SQiL918/MCU-/接线图/02_实物标注.png

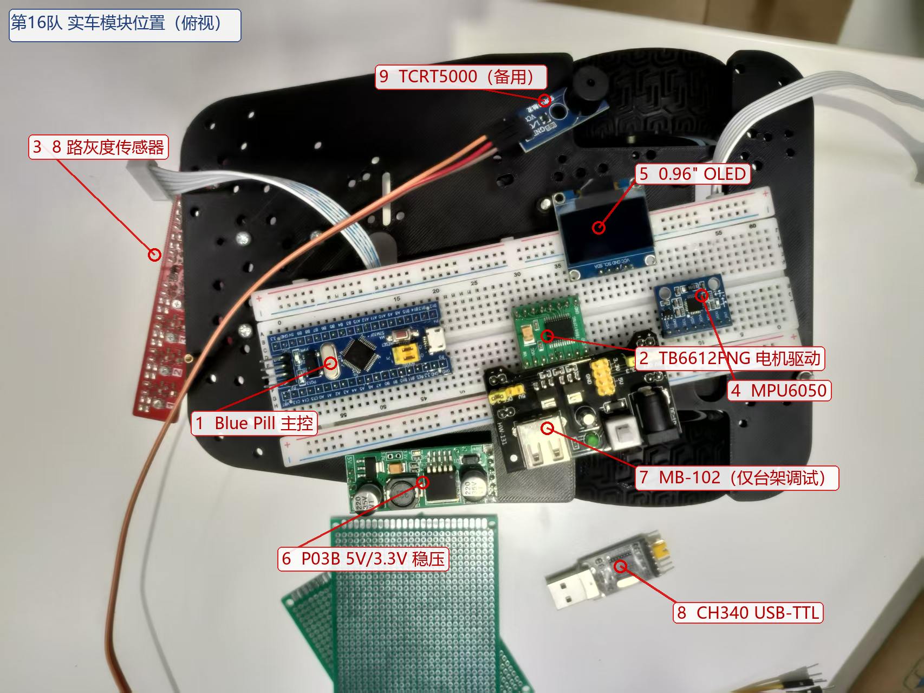
接线图/02_实物标注.png
