SQiL918/MCU-/README.md

# MCU- · 第16队 · 自动行驶小车

基于 Keil5 的小车循迹，原题 2024 年电赛 H 题改编，源码改编自德州电器部分源码与 Gitee 的菠萝虾。

- 题目：A 自动行驶小车
- 主控：STM32F103C8T6（Blue Pill）
- 开发环境：Keil MDK 5.36 + STM32F1 DFP 2.4.1，StdPeriph V3.5
- 当前版本：**release1.10**（2026-11-09，Q2 八路灰度串口循迹 r8）

## 先看这里

| 要做的事 | 打开 |
|---|---|
| 了解交付内容、待确认硬件、下一步 | [`交付说明.md`](交付说明.md) |
| 了解 release1.1 下载问题修复 | [`解决release1.0的问题.md`](解决release1.0的问题.md) |
| 提交设计报告 | [`设计报告/设计报告_自动行驶小车_可提交.docx`](设计报告/设计报告_自动行驶小车_可提交.docx)（8 页） |
| 接线 | [`接线图/接线总表.md`](接线图/接线总表.md)（先读第 1 节供电和第 11 节检查清单） |
| 编译/下载/标定 | [`Keil工程/README.md`](Keil工程/README.md) |
| 本版接线变更（灰度改串口） | [`Keil工程/README.md`](Keil工程/README.md) 第 3 节（OUT1~8 要拔掉） |
| 填登记表 | [`登记表_第16队_手写版.docx`](登记表_第16队_手写版.docx)（队伍信息已填，队员栏手写） |
| 记录调试数据 | [`调试记录/`](调试记录/)（测试记录表、参数标定表、四天计划） |
| 已编译固件 | [`Keil工程/Project.hex`](Keil工程/Project.hex) |

## 目录结构

```
MCU-/
├─ README.md                       仓库说明（本文件）
├─ 交付说明.md                      当前交付说明（先看这个）
├─ 解决release1.0的问题.md          release1.1 下载问题修复记录
├─ Project.hex                      当前版本固件（与 Keil工程/Project.hex 相同）
├─ 登记表_第16队_手写版.docx         队伍信息已填，队员栏手写（默认打印这份）
├─ 登记表_第16队_机打版.docx         姓名/班级/分工已机打，本人签字（备选）
├─ 设计报告/                        设计报告 docx/pdf（提交版，文件名不含队号）
├─ 接线图/                          接线总表 + 系统框图/实物标注/引脚图/流程图
├─ Keil工程/                        Keil5 工程（App/Bsp/Hardware/Library/Start/System/User）
├─ _仿真_主机验证/                   Q2 循迹主机仿真（MSVC 编译，非固件）
└─ 调试记录/                        四天计划、测试记录表、参数标定表
```

### 设计报告

- `设计报告_自动行驶小车_可提交.docx/.pdf`：唯一提交版，文件名不含队号。
- 表 3 的“实测”列留空，赛前联调按 4.1 节跑 3 次填入。

### 接线图

- `接线总表.md`：供电关系、逐引脚表、TB6612、MG513 6P、灰度 2×8、MPU/OLED、
  蜂鸣器/LED/按键/ADC、上电检查清单。
- 四张图：系统框图、实车标注、Blue Pill 引脚、软件流程。
- **release1.10 起灰度模块改接 UART（PA9/PA10），OUT1~8 排线全部拔掉**；
  `接线总表.md` 里的并口灰度接线是旧版，详见 [`Keil工程/README.md`](Keil工程/README.md) 第 3 节。

### Keil 工程

- 器件 STM32F103C8，StdPeriph V3.5，ARMCC V5。
- 200 Hz 控制、20 kHz PWM、TIM3/TIM4 编码器、软件 I2C、Q1~Q4 路径状态机。
- 首次上电必须标定：电机方向、编码器符号、轮径/计数当量、灰度极性、陀螺仪零偏。
- release1.1 修复：`Project.uvoptx` 中已关闭 Debug Description（`Enable=0`），
  解决“编译通过但无法烧录”（`Cannot access Memory @ 0x00000000`）；
  换电脑或换 ST-Link 后只需在 `Debug → Settings` 重选一次调试器，不要重新勾选该选项。

### 调试记录

- `四天计划与测试方案.md`：逐半日计划、里程碑、封存清单。
- `测试记录表.csv`、`参数标定表.csv`：与报告表 3 对应的记录模板，待实测填写。

## 当前状态

- 设计报告：8 页，摘要 262 字，格式符合模板；实测数据待回填。
- 登记表：队伍信息已填；队员姓名/班级/分工按备注由本人手写，另附机打备选版。
- Keil 工程：release1.10 编译 0 Error / 0 Warning（Flash 约 22.8 KB / RAM 约 3.2 KB，含 2 KB 栈）；2026-11-07 已实机下载成功（下载修复见 `解决release1.0的问题.md`）。
- 待确认硬件：MG513 6P 线序、TB6612 模块丝印、电池规格、轮径/轮距、
  蜂鸣器类型、灰度 10 芯排线顺序。

## release1.2 变更（2026-11-07，调参前备份）

跑图 PID 调参前的代码备份，相对 release1.1 的变化：

- 电池采样：改用 D153B 驱动板板载 1/11 分压，ADC 连续 8 次平均，
  新增 `VBAT_ADC_MULT`（=10）补偿分压比/参考电压误差
- 蜂鸣器：改为低电平触发（PB0 = 0 鸣响）
- 调试串口：新增 `gz`（陀螺仪 Z 轴角速度）、MPU6050 `WHO_AM_I`、陀螺仪零偏输出
- 电机/编码器方向：台架实测确认 `MOTOR_*_INVERT = 0` 前进，补充注释
- `Project.hex` 同步为本次构建固件

## release1.4 变更（2026-11-08，声光同步）

相对 release1.2（commit `5154800`），本次只改 `Keil工程/App/ui.c`：

- 新增 `ui_indicator()`：蜂鸣器 PB0、外接 LED PB2、板载 LED PC13 由同一函数驱动，
  启动/过点/停车时声音与灯光严格同步
- 删除 PC13 的 2 Hz 心跳，空闲时不再闪烁
- 提示节奏：启动 100 ms；过点 50/50/50 ms（响两下、闪两下）；停车 500 ms
- `Project.hex` 为本次构建（46,475 B，MD5 `D0CCB89DD44B5F72A2A894258111C6CA`），
  根目录与 `Keil工程/` 各一份、内容相同
- 烧录步骤与上电自检见当时的 `烧录说明.txt`（该文件已随后续版本移除，烧录步骤统一见 [`Keil工程/README.md`](Keil工程/README.md)）

## release1.7 变更（2026-11-08，MPU6050 Yaw 修复 + 电压校准）

相对 release1.4：

- MPU6050 上电初始化加固：上电先等 100 ms，`WHO_AM_I` 应答后最多重试 5 次，
  写完配置回读 `PWR_MGMT_1` 确认退出 sleep，失败时串口打印 `FAIL`
- 修正软件 I2C 读时序：地址 ACK 检查、首字节 ACK、末字节 NACK
- 陀螺仪校准增加量程检测：读数完全不变（stuck bus / 芯片仍在睡眠）判为坏，
  `Imu_IsReady()` 置 0
- OLED 的 `Y:` 在 IMU 未就绪时显示 `Err`，正常时显示 Yaw 数值
- 电池校准 `VBAT_ADC_MULT` 由 10 改为 8（万用表 12.4 V 时 OLED 约 15.55 V）
- `Project.hex` 47,563 B，MD5 `84E272F6D0BA0FFA6311212AB6B206A4`

## release1.9 变更（2026-11-08，Q2 转向修复）

相对 release1.7，只改 `Keil工程/App/path.c` 一行：

- `g_path_q2` 第二段半圆（D→A）的 `arc_dir` 由 `+1`（左转）改为 `-1`（右转），
  与 B→C 段一致；Q2 顺时针整圈 A→B→C→D→A 的转向正确
- `Project.hex` 47,563 B，MD5 `1AF3BE2B38FBC1F25F7DDB2E3702D51B`
- 当时包内的烧录说明同时记录当前限制：灰度 g=255 未解决、Q2 弧线为开环前馈、
  Q3/Q4 段表未改，建议低速单独核对

## release1.10 变更（2026-11-09，Q2 八路灰度串口循迹 r8）

本版把 Q2 的循迹方式整体换掉：灰度模块从 8 根并口线改成 **UART 115200**，
Q2 的直线和两个 180° 弧全部由八路灰度闭环跟线，IMU 只做航向内环和里程/角度保护。

- 新增 `Bsp/gray_uart.c/h`：串口帧解析（`5B` 帧头 + 8×12 位）、300 ms 掉线判定、
  自动重发上传命令 `A5 03 15 02`
- `App/path.c` 重写：新增 `SEG_LINE` / `SEG_ARC_LINE`；灰度误差积分成航向偏置
  （`ARC_LINE_*`，限幅 ±55°），弧线用几何前馈 + 灰度修正
- 弧线→直行增加 180° 交接：里程到后先停稳，航向差 >1° 就原地转到 180° 再直行
  （`ARC_SETTLE_*`）
- 新增 2 s 看门狗、限时等待与 `RST flags` / `FAULT` 诊断；USART1 中断优先级高于 TIM1；
  栈改为 2 KB
- **接线变化**：灰度 TX→PA10、RX→PA9，OUT1~8 全部拔掉；CH340 的 TX 不要再接 PA10
- 主机仿真 `_仿真_主机验证/`：把真实 `path.c` 编到 PC 上跑 Q2 场景（需 MSVC）
- 固件 `Project.hex` 64,295 B，MD5 `E3A9DE6F3D315903728E98747A0BCB13`

### 已知问题（实测，本版尚未解决）

1. 180° 方向调整不是每次都能到位，偶尔调整方向错误。
2. 第二段直行距离不够，到不了下一个半圆，灰度看不到线，第二次循迹失败。
3. 灰度循迹左右画龙、抖动过大，行驶不平稳。

## 版本

| 版本 | 日期 | 说明 |
|---|---|---|
| release1.0 | 2026-11-05 | 首次交付：Keil 工程、设计报告、接线图、调试记录、登记表 |
| release1.1 | 2026-11-07 | 修复 Keil 下载问题：关闭 Debug Description（.dbgconf），实机烧录成功 |
| release1.2 | 2026-11-07 | 调参前备份：电池采样、蜂鸣器、调试串口更新，准备跑图调 PID |
| release1.4 | 2026-11-08 | 声光同步：`ui_indicator()` 统一驱动蜂鸣器/PB2/PC13，过点声光同步 |
| release1.7 | 2026-11-08 | MPU6050 上电初始化修复，OLED 可读 Yaw；`VBAT_ADC_MULT=8` |
| release1.9 | 2026-11-08 | Q2 第二段半圆（D→A）改为右转，顺时针整圈方向正确 |
| release1.10 | 2026-11-09 | Q2 改八路灰度串口循迹 + 180° 交接；已知抖动、第二段距离不足 |
