SQiL918/MCU-/解决release1.0的问题.md

# MCU 二面 · 第16队 · 工作目录

题目 A：自动行驶小车。主控 STM32F103C8T6。
比赛时间：2026-11-05 08:00 — 2026-11-08 20:00。

## 版本记录

**release1.1（2026-11-07）· 修复 Keil 下载问题：** 此前本工程出现“编译通过但无法烧录”——Keil 报 `Cannot access Memory (@ 0x00000000, Write, Acc Size: 8 Byte)`，命令行下报 `No ST-LINK detected`，而同一台电脑、同一只 ST-Link 烧录其他 LED 工程正常；根因是工程的用户配置文件 `Project.uvoptx` 中开启了 **Debug Description（.dbgconf 调试描述）**，Keil 会在连接芯片前按 `DebugConfig\*.dbgconf` 去写 DBGMCU 调试寄存器，这一步失败就把错误报在 0 地址并中止下载；解决方法是在 `Options for Target → Debug` 中关闭 Debug Description（或退出 Keil、删除 `Project.uvoptx` 后重开工程，在 `Debug → Settings` 里重新选中本机 ST-Link），本工程已改为 `DebugDescription/Enable = 0`，实测编译 0 Error / 0 Warning、下载成功；换电脑或换 ST-Link 后若再提示找不到调试器，只需在 `Debug → Settings` 里重选一次，不要重新勾选该选项。

## 先看这里

| 要做的事 | 打开 |
|---|---|
| 了解交付内容、待确认硬件、下一步 | `交付说明.md` |
| 提交设计报告 | `设计报告/设计报告_自动行驶小车_可提交.docx`（8 页） |
| 接线 | `接线图/接线总表.md`（先读第 1 节供电和第 11 节检查清单） |
| 编译/下载/标定 | `Keil工程/README.md` |
| 看原始题目和材料 | `原始材料/` |
| 填登记表 | `提交包/登记表_第16队_手写版.docx`（队伍信息已填，队员栏手写） |
| 记录调试数据 | `提交包/调试记录/`（测试记录表、参数标定表、四天计划） |
| 发给李队的整包 | `提交包/第16队_交付包_2026-11-05.zip` |

## 目录说明

```
MCU二面/
├─ 交付说明.md              当前交付说明（先看这个）
├─ 设计报告/               设计报告 docx/pdf（提交版，文件名不含队号）
├─ 接线图/                 接线总表 + 系统框图/实物标注/引脚图/流程图
├─ Keil工程/               Keil5 工程（App/Bsp/Hardware/System/User）
├─ 过程文档/               题目分析、方案、计划、测试表、答辩要点
├─ 原始材料/               题目原件、参考资料、李队发来的材料
├─ 提交包/                 交付 zip、登记表、调试记录表
└─ 归档/                   报告/接线图的生成脚本（重建用）
```

### 设计报告

- `设计报告_自动行驶小车_可提交.docx/.pdf`：唯一提交版，文件名不含队号。
- 表 3 的“实测”列留空，赛前联调按 4.1 节跑 3 次填入。

### 接线图

- `接线总表.md`：供电关系、逐引脚表、TB6612、MG513 6P、灰度 2×8、MPU/OLED、
  蜂鸣器/LED/按键/ADC、上电检查清单。
- 四张图：系统框图、实车标注、Blue Pill 引脚、软件流程。

### Keil 工程

- 器件 STM32F103C8，StdPeriph V3.5，ARMCC V5。
- 200 Hz 控制、20 kHz PWM、TIM3/TIM4 编码器、软件 I2C、Q1~Q4 路径状态机。
- 首次上电必须标定：电机方向、编码器符号、轮径/计数当量、灰度极性、陀螺仪零偏。

### 过程文档

按阅读顺序：题目规则 → 团队分工 → 技术方案 → 四天计划 → 待确认信息 →
报告大纲 → 上游代码分析 → 安全叮嘱 → 答辩要点 → 测试记录表 → 参数标定表 →
开源项目对比。

## 当前状态

- 设计报告：8 页，摘要 262 字，格式符合模板；实测数据待回填。
- 登记表：队伍信息已填；队员姓名/班级/分工按备注由本人手写，另附机打备选版。
- Keil 工程：Keil MDK 5.36 + DFP 2.4.1 编译通过（0 Error / 0 Warning，Flash 16.4 KB / RAM 1.8 KB）；2026-11-07 已实机下载成功（下载问题与修复见上方“版本记录”）。
- 待确认硬件：MG513 6P 线序、TB6612 模块丝印、电池规格、轮径/轮距、
  蜂鸣器类型、灰度 10 芯排线顺序。
