SQiL918/MCU-/交付说明.md

# 交付说明（2026-11-05 晚）

## 1. 这次交付了什么

| 文件/目录 | 内容 | 状态 |
|---|---|---|
| `设计报告/设计报告_自动行驶小车_可提交.docx` | 按学校模板生成的设计报告，8 页，262 字摘要 | 可提交，实测数据待回填 |
| `设计报告/设计报告_自动行驶小车_可提交.pdf` | 同上 PDF，便于预览/打印 | 8 页 |
| `接线图/接线总表.md` | 逐引脚接线表、供电关系、6P 编码器识别、上电检查清单 | 完成 |
| `接线图/01_系统框图.png` | 系统总体框图（报告图1） | 完成 |
| `接线图/02_实物标注.png` | 实车模块位置标注（报告图2） | 完成 |
| `接线图/03_BluePill引脚图.png` | Blue Pill 引脚分配图（备用/讲解用） | 完成 |
| `接线图/04_软件流程图.png` | 软件总体流程（报告图3） | 完成 |
| `Keil工程/` | Keil5 工程，可直接编译/下载 | Keil MDK 5.36 + DFP 2.4.1 编译通过，0 Error 0 Warning |
| `Keil工程/README.md` | 编译、下载、标定、串口、故障排查 | 完成 |
| `提交包/登记表_第16队_手写版.docx` | 队伍信息已填，队员姓名/班级/分工留空，供本人手写 | 默认打印这份 |
| `提交包/登记表_第16队_机打版.docx` | 姓名/班级/分工已机打，本人只需签字 | 备选 |
| `调试记录/四天计划与测试方案.md` | 逐半日计划、里程碑、封存清单 | 完成 |
| `调试记录/测试记录表.csv` | 每次跑车记录模板，列与报告表 3 对应 | 待填 |
| `调试记录/参数标定表.csv` | 轮径、轮距、编码器、死区、IMU、灰度、PID 标定 | 待填 |
| `原始材料/材料_2026-11-05/` | 李队发来的材料解压（手册、例程、三维模型） | 参考 |

## 2. 报告怎么用

- 封面：题目编号 A、题目名称“自动行驶小车”，参赛队编号/校区留空；
  如学校要求填，按现场要求填。正文没有出现学校、姓名、队号。
- 摘要：262 字，符合 300 字以内。
- 格式：A4，上边距 3.0 cm，小四宋体，固定 22 pt 行距，页码右下角。
- PDF 已用 WPS 导出复核：8 页，正文、图表、页码正常。
- 4.2 节表 3 的“实测”列是空的，赛前联调后按 4.1 节重复 3 次填入；
  这是唯一需要你们补的数据。
- 为压到 8 页，报告正文没有放附录 A/B 和参考文献；如果评委允许超页，
  可以把 `Keil工程/README.md` 的引脚表、`app_config.h` 的参数表、
  代码节选补到附录。当前 8 页是硬限制下的版本。

## 3. 接线图怎么用

1. 先看 `接线图/接线总表.md` 第 1 节供电关系：电池→保险丝→开关→P03B/TB6612，
   所有 GND 星形汇接。
2. 按第 2 节引脚表逐根接；灰度 OUT 全部接在 5 V 容忍引脚上。
3. 按第 4 节用万用表确认 MG513 的 6P 线序（M1/M2、VCC、GND、C1、C2），
   **不要凭颜色直接插**。
4. 按第 5 节接灰度 2×8 排针：OUT1~8 + 5V + GND，TX/RX/SCL/SDA/SWD 留空。
5. 按第 11 节上电检查清单，先架空车轮、限流 0.5 A，再落地。

## 4. Keil 工程怎么用

1. 打开 `Keil工程/Project.uvprojx`，器件选 STM32F103C8，编译。
2. ST-Link 接 SWDIO/SWCLK/GND/3.3V；BOOT0=0，按复位下载。
3. 首次上电按 `Keil工程/README.md` 第 4 节标定：
   电机方向、编码器符号、轮径/计数当量、灰度极性、陀螺仪零偏。
4. 先低速 300~450 mm/s 跑 Q1/Q2，再提速；Q3/Q4 的 38.66°转向参数
   `TURN_KP` 先保持默认 5.0。
5. 工程已在本机 Keil MDK 5.36 实测编译：0 Error / 0 Warning，Flash 16.4 KB；
   `Keil工程/Project.hex` 是现成固件，可直接烧录。

## 5. 还需要李队确认/补的硬件事实

这些不影响代码框架，但会影响第一次上电是否顺利：

1. **电池**：几 S、容量、有没有 12 V 电池盒/XT60/DC 头、有没有 5 A 保险丝和开关。
   代码按 3S（11.1 V，满电 12.6 V）设计；如果是 2S，速度会低一些，仍能跑。
2. **MG513 6P 线序**：按接线总表第 4 节用万用表确认；确认后把线色/顺序拍照发我。
3. **TB6612 模块丝印**：绿色模块不同批次引脚顺序可能不同；以丝印为准，
   确认 VM/VCC/GND、PWMA/AIN1/AIN2/STBY/BIN1/BIN2/PWMB 的位置。
4. **轮径/轮距**：用卡尺量轮子直径、两轮中心距；如果轮径不是 65 mm，
   改 `COUNTS_PER_MM` 和 `WHEEL_DIAMETER_MM`。
5. **蜂鸣器**：确认是有源还是无源；无源需要改代码输出 2 kHz PWM。
6. **灰度排线**：现有 10 芯排线如果已经压好，用万用表逐根确认
   OUT1~8 + 5V + GND 的顺序，不要假设。
7. **Q3 原地转向规则**：当前代码用“内轮停、外轮进”的前进式转向，
   不反转；如果裁判认为内轮停也不符合“只能前进”，改为
   `TURN_INNER_RATIO=0.3`（两轮都前进，转半径更大）。

## 6. 建议的下一步（按优先级）

1. **今天/明天上午**：按接线总表接好电源、主控、TB6612、编码器、灰度、MPU、OLED；
   架空车轮，烧录，串口确认 `BOOT`、`IMU calibration done`。
2. **明天下午**：标定电机方向、编码器符号、轮径、灰度极性；跑 Q1 直线，
   调 `YAW_KP`；再跑 Q2 圆弧，调 `LINE_KP/KD`。
3. **11 月 7 日**：跑 Q3 的 38.66°转向和对角线；调 `TURN_KP`、
   `ARC_FINISH_MARGIN_MM`；补表 3 实测数据。
4. **11 月 8 日**：Q4 四圈连续测试；检查电池电压、轮胎、保险丝；
   按 `过程文档/04_四天计划与测试方案.md` 的封存清单打包。

## 7. 登记表怎么填

登记表由参赛队自己填，评委只填“实车/报告得分、总分、评委签字”。原件备注写明：
“队员信息与分工由队员本人填写并签字”。所以给了两版：

- `登记表_第16队_手写版.docx`：只印好队伍名称/编号/题目，队员三行空着，本人手写。**默认打这份。**
- `登记表_第16队_机打版.docx`：姓名/班级/分工已打好，本人核对后签字。赶时间用这份。

| 栏位 | 填法 |
|---|---|
| 队伍名称 | 第16队（已印） |
| 队伍编号 | 16（已印，如群里有三位编号现场改） |
| 参赛题目 | 自动行驶小车（原件已印） |
| 队员姓名/班级（1→3） | 李队 25区块链2班；梁亮 24计算机1班；蔡宇 26电气G1班 |
| 分工（1→3） | 李队 硬件方案/电源与结构/整车统稿；梁亮 软件设计/控制算法/程序调试；蔡宇 接线与硬件调试/测试记录/报告排版 |
| 测试日期 | 测试当天填 |
| 本人签字、队长签字 | 本人签，不代签 |
| 评分、总分、评委签字 | 全部留空，评委填 |

登记表**不是匿名材料**，姓名、班级必须真实；匿名要求只针对设计报告。

## 8. 风险提醒

- **电源**：P03B 输入标 12/24 V，3S 满电 12.6 V 没问题；不要同时接 MB-102 的 5 V
  和 P03B 的 5 V。
- **灰度 OUT 高电平约 4 V**：已接 FT 引脚；不要改到 PA0~PA7/PB0/PB1 等非 FT 脚。
- **编码器 VCC**：默认 3.3 V，保护 PA6/PA7；如果该批次必须 5 V，必须加限幅。
- **TB6612 电流**：连续 1.2 A/通道，不要让轮子长时间堵转；VM 端并 100 µF。
- **报告页数**：当前 8 页；如果补附录会超页，优先保留正文和表 3。
