SQiL918/MCU-/接线图/03_BluePill引脚图.png

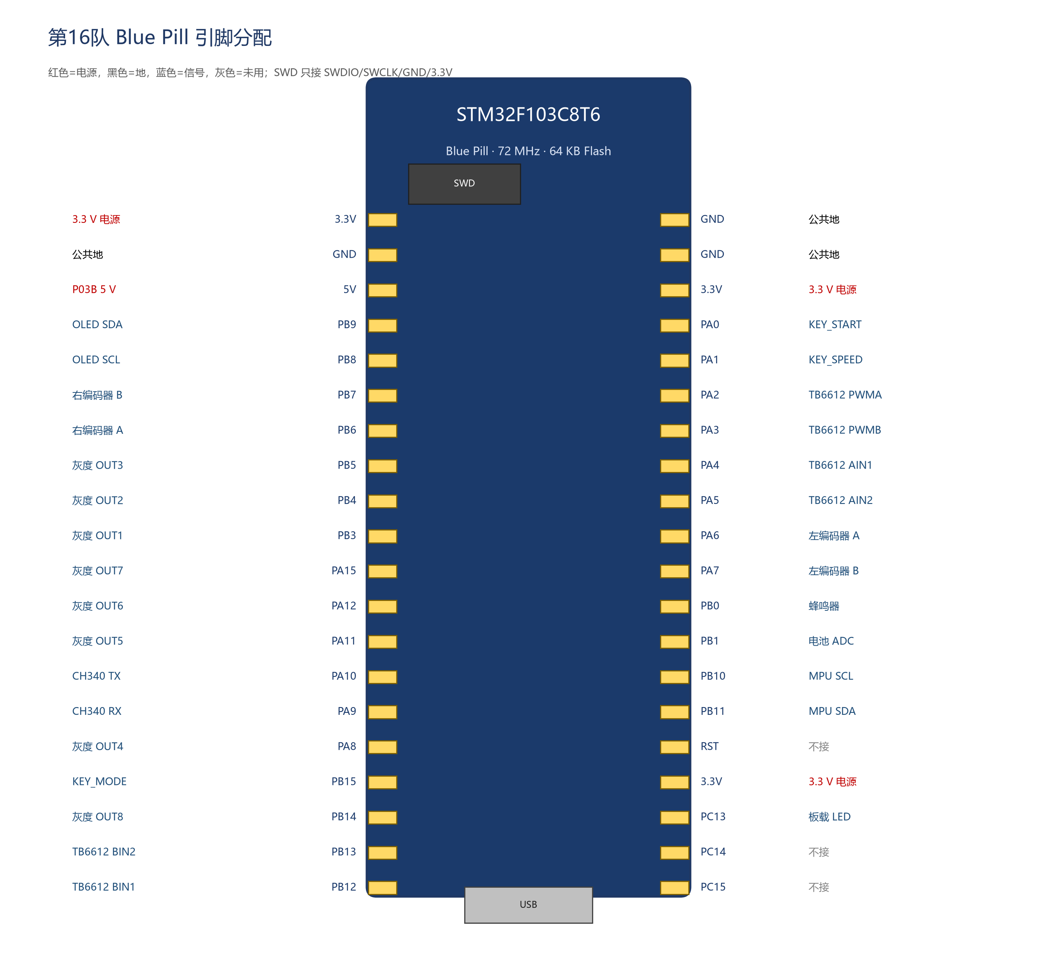
接线图/03_BluePill引脚图.png
