SQiL918/MCU-/调试记录/四天计划与测试方案.md

# 四天作战计划与测试方案

时间基准：2026-11-05 13:20 — 11-08 20:00，约 78.5 小时。
原则：**先通模块，再通单题，再通全程；先保稳定，再提速；报告同步写。**

## 1. 逐半日计划

### 11-05（D0）今天

| 时间 | 任务 | 产出/验收 |
|---|---|---|
| 13:30–15:00 | 硬件盘点、拍照、要手册；确认主控/驱动/灰度/IMU/OLED/电池 | 硬件清单填完；引脚丝印照片 |
| 15:00–16:00 | 电源检查：极性、短路、5 V/3.3 V、共地；只给主控上电 | 主控 3.3 V 正常，SWD 能连 |
| 16:00–17:00 | 开发环境：新建工程、时钟 72 MHz、LED 闪、下载成功 | 能编译/下载/复位 |
| 17:00–18:00 | OLED、按键、蜂鸣器、LED 自检 | 显示/翻页/响/亮 |
| 18:00–20:00 | 电机方向、PWM、编码器计数；架空测 | 两轮正转，计数正确 |
| 20:00–22:00 | 灰度读数、IMU 读数、ADC 电压 | 串口/OLED 能看到数据 |
| 22:00–23:30 | Q1：A→B 直行停车 | 连续 3 次成功，记时间 |

**D0 必须达到**：所有模块能读/能动；Q1 能跑。达不到就压缩后面的功能，不要跳过电源检查。

### 11-06（D1）

| 时间 | 任务 | 产出/验收 |
|---|---|---|
| 08:30–10:00 | 速度环整定（左右独立） | 阶跃无明显振荡 |
| 10:00–12:00 | 航向环整定；直道 100 cm 偏差 | 偏差 ≤ 3 cm |
| 13:30–15:30 | 灰度阈值/高度；圆弧低速循迹 | 圆弧不脱线 |
| 15:30–18:00 | Q2 全路径：直道→弧→直道→弧→停车 | 单圈 ≤ 30 s，连续 3 次 |
| 18:00–19:00 | OLED 队名/轮速/调速界面 | 5 分项可演示 |
| 19:00–22:00 | Q2 提速与稳定性；记录数据 | 10 次通过率 ≥ 70% |
| 22:00–23:00 | 代码 commit、备份；报告方案/理论初稿 | 有可回滚版本 |

**D1 必须达到**：Q2 连续 3 次 ≤ 30 s；OLED 5 分项能演示。

### 11-07（D2）

| 时间 | 任务 | 产出/验收 |
|---|---|---|
| 08:30–10:00 | Q3 斜线：航向 + 距离闭环 | 斜线偏差 ≤ 3 cm |
| 10:00–12:00 | C/B/D 点位对准、找弧、换向 | 单圈 ≤ 40 s |
| 13:30–16:00 | Q3 全路径连续跑 | 连续 3 次成功 |
| 16:00–18:00 | Q4 四圈：圈数状态机、A 点重新对准 | 至少 1 次完整四圈 |
| 18:00–20:00 | Q4 稳定性/提速；记录 | 不脱线优先 |
| 20:00–22:00 | 回归 Q1/Q2，防止改坏 | 各 3 次通过 |
| 22:00–23:00 | 报告测试数据整理；代码备份 | 数据表填完 |

**D2 必须达到**：Q3 单圈 ≤ 40 s；Q4 至少 1 次完整。达不到就保 Q2，Q3/Q4 尽力。

### 11-08（D3）

| 时间 | 任务 | 产出/验收 |
|---|---|---|
| 08:30–10:30 | 最后调参；连续 10 次稳定性 | 通过率 ≥ 80% |
| 10:30–12:00 | 选定比赛版本；烧录；记录参数 | 已知-good hex + 参数表 |
| 12:00–13:00 | **代码冻结**；两份备份；整理工具/备件 | 不再改功能 |
| 13:00–15:30 | 报告统稿：摘要、图表、测试数据 | 8 页内，格式合规 |
| 15:30–17:00 | 打印、装订、密封纸、页码检查 | 符合提交要求 |
| 17:00–18:30 | 实物检查：螺丝、线、电池、轮胎、备用件 | 封箱清单 |
| 18:30–19:30 | 封箱前最后通电自检（按评委要求） | 程序脱机固化 |
| 20:00 | 停止调试，封存 | 报告/实物/登记表 |

## 2. 里程碑与 Go/No-Go

| 里程碑 | 时间 | 通过标准 | 不通过怎么办 |
|---|---|---|---|
| M1 模块全通 | 11-05 23:00 | 每个模块能读/能动 | 第二天上午补，砍非必要功能 |
| M2 Q1 | 11-05 23:30 | 3/3 成功 | 先修电源/编码器，不急着 Q2 |
| M3 Q2 | 11-06 23:00 | 3/3 ≤ 30 s | 降速，保不脱线 |
| M4 Q3 | 11-07 12:00 | 1/1 ≤ 40 s | 先保 Q2，Q3 用低速 |
| M5 Q4 | 11-07 23:00 | 至少 1 次完整 | 11-08 上午继续，仍不成就保 Q3 |
| M6 稳定性 | 11-08 10:30 | 10 次 ≥ 8 次 | 冻结当前最好版本 |

## 3. 测试矩阵

| 测试 | 次数 | 通过标准 | 记录项 |
|---|---|---|---|
| Q1 A→B | 10 | 停车覆盖 B，声光同时，≤ 15 s | 时间、停车偏差、提示 |
| Q2 单圈 | 10 | 每点提示，弧线不脱，≤ 30 s | 时间、脱线次数、漏提示 |
| Q3 单圈 | 10 | 每点提示，弧线不脱，≤ 40 s | 时间、脱线次数、斜线偏差 |
| Q4 四圈 | 5 | 4 圈完整，停车覆盖 A | 总时间、脱线、圈数 |
| OLED/调速 | 3 | 队名、左右轮速、调速可见 | 照片/视频 |
| 低电压 | 1 | 电压下降后仍能跑/报警 | 电压、现象 |
| 连续稳定性 | 10 | ≥ 8 次通过 | 通过率、失败原因 |

测试条件固定：同一地面、同一光照、同一胎压/轮胎清洁、同一电池起始电压、同一场地位置。每次测试前把车放回 A 点同一位置/方向。

## 4. 每次跑车前后检查清单

跑前：

- [ ] 电池电压 ≥ 约定值（满电或 ≥ 7.4 V，按实际电池）
- [ ] 轮子/电机线/传感器线无松动
- [ ] 灰度镜头干净，高度未变
- [ ] IMU 固定牢，yaw 已归零/无漂移
- [ ] 场地 A/B/C/D 位置未动
- [ ] OLED 显示模式/速度正确

跑后：

- [ ] 记录时间、脱线、漏提示、停车位置
- [ ] 摸电机/驱动是否过热
- [ ] 检查电池电压
- [ ] 保存异常现象（视频/照片）
- [ ] 如果改了参数，记下旧值/新值

## 5. 代码冻结与备份

1. **11-08 13:00 冻结**：不再加功能，不再改控制参数；只允许修“导致不能跑”的问题，且要回归 Q1/Q2。
2. 备份两份：笔记本 + U 盘；包含源码、hex、参数表、接线图、报告。
3. 烧录后**脱机运行**验证一次（拔掉 ST-Link，重启，跑 Q1）。
4. 记录“比赛版本”的 commit/tag、编译时间、参数表；封箱后不再改。
5. 工具清单：ST-Link、USB 线、备用电池、螺丝刀、扎带、绝缘胶带、万用表、备用传感器/电机、充电器。

## 6. 封存清单

- [ ] 《设计报告》打印/装订/密封纸/页码/无学校姓名队号
- [ ] 制作实物（车、电池、遥控？不允许遥控；只封车和必要附件）
- [ ] 《登记表》
- [ ] 程序已脱机固化
- [ ] 未封入箱的开发板、仿真器、U 盘不带入测评现场
- [ ] 封条/签字/拍照留证

## 7. 时间不够时的取舍

优先级从高到低：

1. Q1 + Q2（35 分）——必须保。
2. OLED + 调速（5 分）——成本低，必须保。
3. 报告（20 分）——格式完整就能拿大部分。
4. Q3（30 分）——在 Q2 稳定后冲。
5. Q4（30 分）——Q3 稳定后再冲。

**不要为了 Q4 牺牲 Q2**：Q2 跑不稳，Q3/Q4 更不可能；而且 Q2 是基础。
