SQiL918/MCU-/调试记录/参数标定表.csv

类别 | 参数 | 符号 | 单位 | 数值 | 测量方法/备注
基础 | 主控型号 |  |  | STM32F103C8T6 | 题目指定
基础 | 开发环境 |  |  | 待定 | Keil/CubeIDE
几何 | 轮径 | D | mm |  | 卡尺或走1m数圈
几何 | 轮距 | L | mm |  | 两轮接地中心距
几何 | 车重 | m | g |  | 厨房秤
编码器 | 线数 | PPR | 脉冲/圈 |  | 电机标签/手册
编码器 | 减速比 | i | :1 |  | 电机标签/手册
编码器 | 每厘米计数 |  | counts/cm |  | 推1m，读左右计数，3次平均
电机 | 左轮死区 |  | PWM |  | 从0慢慢加，轮子开始转
电机 | 右轮死区 |  | PWM |  | 同上
电机 | 最大PWM |  | counts |  | TIMPWM ARR
IMU | yaw符号 |  | +/- |  | 手动转90度看增减
IMU | 静止漂移 |  | deg/min |  | 静止2min记录
IMU | 输出率 |  | Hz |  | 按手册配置
灰度 | 路数 |  | 路 |  | 8/12
灰度 | 安装高度 | h | mm |  | 距地
灰度 | 前瞻距离 |  | mm |  | 传感器到车轴
灰度 | 每路阈值 |  | 0/1 |  | 白/黑分别读
ADC | 分压比 |  |  |  | R1/R2
ADC | 校准斜率 | k | V/count |  | 万用表两点校准
ADC | 校准截距 | b | V |  | 同上
控制 | 控制周期 | T | ms | 5 | TIM6
PID | 速度环Kp |  |  |  | 先内环
PID | 速度环Ki
PID | 速度环Kd |  |  |  | 速度环一般不用D
PID | 航向环Kp
PID | 航向环Kd
PID | 灰度环Kp
PID | 灰度环Kd
PID | 距离环Kp
路径 | AB距离 |  | cm | 100 | 实测
路径 | BC弧长 |  | cm | 125.66 | πr
路径 | CD距离 |  | cm | 100 | 实测
路径 | DA弧长 |  | cm | 125.66 | πr
路径 | AC斜线 |  | cm | 128.06 | 实测/几何
路径 | BD斜线 |  | cm | 128.06 | 实测/几何
路径 | 斜线角度 |  | deg | 38.66 | atan(80/100)
速度 | Q1目标 |  | cm/s
速度 | Q2直道 |  | cm/s
速度 | Q2弧线 |  | cm/s
速度 | Q3直道 |  | cm/s
速度 | Q3弧线 |  | cm/s
速度 | Q4直道 |  | cm/s
速度 | Q4弧线 |  | cm/s
