SQiL918/MCU-/Keil工程/Hardware/OLED.h

#ifndef __OLED_H
#define __OLED_H

void OLED_Init(void);
void OLED_Clear(void);
void OLED_ShowChar(uint8_t Line, uint8_t Column, char Char);
void OLED_ShowString(uint8_t Line, uint8_t Column, char *String);
void OLED_ShowNum(uint8_t Line, uint8_t Column, uint32_t Number, uint8_t Length);
void OLED_ShowSignedNum(uint8_t Line, uint8_t Column, int32_t Number, uint8_t Length);
void OLED_ShowHexNum(uint8_t Line, uint8_t Column, uint32_t Number, uint8_t Length);
void OLED_ShowBinNum(uint8_t Line, uint8_t Column, uint32_t Number, uint8_t Length);

/* low-level helpers used by the 16x16 Chinese glyph renderer */
void OLED_SetCursor(uint8_t Y, uint8_t X);
void OLED_WriteData(uint8_t Data);
void OLED_ShowChinese16(uint8_t X, uint8_t Page, const uint8_t *Bitmap);

#endif
