SQiL918/MCU-/Keil工程/Hardware/OLED_CN.h

#ifndef __OLED_CN_H
#define __OLED_CN_H

#include "stm32f10x.h"

/* 16x16 SimSun glyphs: 第十六队, packed page-major. */

static const uint8_t CN_DI[32] = {
    0x08, 0x04, 0x93, 0x92, 0x96, 0x9A, 0x92, 0xFA, 0x94, 0x93, 0x92, 0x96, 0xFA, 0x02, 0x02, 0x00,
    0x40, 0x40, 0x47, 0x24, 0x24, 0x14, 0x0C, 0xFF, 0x04, 0x04, 0x24, 0x44, 0x24, 0x1C, 0x00, 0x00,
};

static const uint8_t CN_SHI[32] = {
    0x40, 0x40, 0x40, 0x40, 0x40, 0x40, 0x40, 0xFF, 0x40, 0x40, 0x40, 0x40, 0x40, 0x40, 0x40, 0x00,
    0x00, 0x00, 0x00, 0x00, 0x00, 0x00, 0x00, 0xFF, 0x00, 0x00, 0x00, 0x00, 0x00, 0x00, 0x00, 0x00,
};

static const uint8_t CN_LIU[32] = {
    0x20, 0x20, 0x20, 0x20, 0x20, 0x20, 0x21, 0x22, 0x2C, 0x20, 0x20, 0x20, 0x20, 0x20, 0x20, 0x00,
    0x00, 0x40, 0x20, 0x10, 0x0C, 0x03, 0x00, 0x00, 0x00, 0x01, 0x02, 0x04, 0x18, 0x60, 0x00, 0x00,
};

static const uint8_t CN_DUI[32] = {
    0x00, 0xFE, 0x02, 0x22, 0xDA, 0x06, 0x00, 0x00, 0x00, 0xFF, 0x00, 0x00, 0x00, 0x00, 0x00, 0x00,
    0x00, 0xFF, 0x08, 0x10, 0x88, 0x47, 0x20, 0x18, 0x07, 0x00, 0x07, 0x18, 0x20, 0x40, 0x80, 0x00,
};

#endif
