SQiL918/MCU-/(commit log)

2026-11-07 release1.0: 导入第16队交付包
    - Keil5 工程（STM32F103C8T6，StdPeriph V3.5，含已编译 Project.hex）
    - 设计报告 docx/pdf（8 页，提交版）
    - 接线总表与四张接线图
    - 调试记录：四天计划、测试记录表、参数标定表
    - 登记表（手写版/机打版）
    - README 更新为交付包目录索引
    [参数标定表.csv, 测试记录表.csv]
2026-11-07 release1.1: 修复 Keil 编译通过但无法烧录的问题
    - 新增 Project.uvoptx，关闭 Debug Description（Enable=0），
    避免连接芯片前写 DBGMCU 失败导致 Cannot access Memory @ 0x00000000
    - 新增 DebugConfig/*.dbgconf（STM32F103C6/C8/CB）
    - 更新 Project.uvprojx（Keil 重新保存）与 Project.hex（重新编译）
    - 新增 解决release1.0的问题.md，记录根因与处理方法
    - README 更新版本记录与下载说明
2026-11-07 release1.2: 跑图调 PID 前的版本备份
    - 电池采样改用 D153B 板载 1/11 分压，ADC 连续 8 次平均，新增 VBAT_ADC_MULT 校准
    - 蜂鸣器改为低电平触发
    - 调试串口新增 gz（陀螺仪 Z 轴角速度）、MPU6050 WHO_AM_I、陀螺仪零偏
    - 电机/编码器方向补充台架实测说明
    - Project.hex 同步为本次构建固件
    - README 更新 release1.2 变更与版本记录
2026-11-08 release1.4: 声光同步（启动/过点/停车蜂鸣器与 LED 同步）
    - 新增 ui_indicator()，蜂鸣器 PB0、外接 LED PB2、板载 LED PC13 由同一函数驱动
    - 删除 PC13 的 2 Hz 心跳，空闲时不再自闪
    - 提示节奏：启动 100 ms、过点 50/50/50 ms、停车 500 ms
    - 新增 烧录说明.txt（烧录步骤与上电自检）
    - 更新 Project.hex（46,475 B，MD5 D0CCB89D…），根目录与 Keil工程/ 各一份
    - README 更新 release1.4 说明与版本记录
2026-11-08 release1.7: 修复 MPU6050 上电读取，OLED 可显示 Yaw
    - IMU 初始化：上电延时 100 ms，WHO_AM_I 检测 + 最多 5 次重试，
    回读 PWR_MGMT_1 确认退出 sleep，失败打印 FAIL
    - 修正软件 I2C 读时序：地址 ACK 检查、首字节 ACK、末字节 NACK
    - 校准增加零漂量程检测，异常时 Imu_IsReady()=0，OLED 显示 Y:Err
    - VBAT_ADC_MULT 10 -> 8（万用表 12.4 V 校准）
    - 更新 Project.hex（47,563 B，MD5 84E272F6…）与 烧录说明.txt
    - README 更新 release1.7 说明
    [app_config.h, imu.c, imu.h, ui.c]
2026-11-08 release1.9: 修复 Q2 第二段半圆转向，顺时针可整圈绕行
    - path.c: g_path_q2 第二段弧（D→A）的 arc_dir 由 +1 改为 -1（右转）
    - 更新 Project.hex（47,563 B，MD5 1AF3BE2B…）与根目录副本
    - 烧录说明.txt 更新为 Q2 转向修复版，记录灰度/Q3Q4 等已知限制
    - README 更新 release1.9 说明
    [path.c]
2026-11-09 release1.10: Q2 改用八路灰度串口循迹，增加 180° 交接
    - 新增 Bsp/gray_uart.c/h：115200 串口帧解析、掉线判定与重发
    - path.c 重写：SEG_LINE / SEG_ARC_LINE，灰度误差积分成航向偏置
    - 弧线结束增加 180° 交接：停稳后原地转到 180° 再直行
    - 新增 2 s 看门狗、RST/FAULT 诊断，USART1 优先级调整，栈 2 KB
    - 接线变化：灰度 TX→PA10、RX→PA9，OUT1~8 拔掉
    - 新增 _仿真_主机验证（把真实 path.c 编到 PC 跑 Q2 场景）
    - 固件 Project.hex 64,295 B，MD5 E3A9DE6F…
    - 移除已过期的 烧录说明.txt，烧录说明并入 Keil工程/README.md
    - README 记录本版已知问题（方向调整、第二段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
    [app_config.h, bsp.c, bsp.h, control.c, debug.c, gray_uart.c, gray_uart.h, imu.c]
